nomike/doxy-replacement-shell/print-instructions.md

See <doxy-replacement-shell-v2.scad> for details on how to print and assemble this.
