nomike/doxy-replacement-shell/(commit log)

2024-01-22 First commit.
    [doxy-shell.scad]
2024-01-22 Fix connecting ridge and cable cutout.
    [doxy-shell.scad]
2024-01-22 Remove old code.
    [doxy-shell.scad]
2024-01-22 Add connecting ridges to other half.
    [doxy-shell.scad]
2024-01-22 Add comments to code.
    [doxy-shell.scad]
2024-01-22 Add screw holes to screw holders.
    [doxy-shell.scad]
2024-01-22 More details.
    [doxy-shell.scad]
2024-01-22 .stl files are generated. Tell git to ignore them.
2024-01-22 Reduce detail for faster rendering.
    [doxy-shell.scad]
2024-02-08 Fix spelling.
    [doxy-shell.scad]
2024-02-13 Ad GPLv3 header to source file.
    [doxy-shell.scad]
2024-04-05 Adjust grip_cone_with after re-measuring it.
    [doxy-shell.scad]
2024-04-05 Add print-instructions.
2024-04-05 Upload new STL files to thingiverse.
2024-04-07 Fix license header in OpenSCAD file.
    [doxy-shell.scad]
2024-04-08 Fix comment in doxy-shell.scad.
    [doxy-shell.scad]
2024-04-13 Rename openscad file to be more consistent.
    [doxy-replacement-shell.scad]
2024-09-19 Complete rewrite of the script. First draft.
    [doxy-replacement-shell-v2.scad]
2024-09-21 Add function `get_max_dimension`.
    [doxy-replacement-shell-v2.scad]
2024-09-21 Allkow shaft segments to not be hollow.
    [doxy-replacement-shell-v2.scad]
2024-09-21 Multiple improvements and fixes:
    - Support separate `screw_holder_screwhead_insert_offset`s per screw holder.
    - Consider ridge height when calculating `bottom_screw_holder_height`. Otherwise it will be floating ever so slightly in the air and the very thin support structure underneath will fail mid print and caus the print to fail.
    - Clean the other surface. This is needed to get rid of remnants from the screw holder supports.
    - Make screw holder supports configurab le in height by a fraction of the screw holder height.
    - Add button holes and button hole ridges
    [doxy-replacement-shell-v2.scad]
2024-09-22 Make rendering of button- and nonbutton-halfs configurable.
    [doxy-replacement-shell-v2.scad]
2024-09-23 Use correct variable for cable-end screw holder on button half.
    [doxy-replacement-shell-v2.scad]
2024-09-23 Make button half screw holes a bit tighter for a better screw fit.
    [doxy-replacement-shell-v2.scad]
2024-09-23 Cut off a piece from the PCB screw holder to make room for th silicon button-piece.
    [doxy-replacement-shell-v2.scad]
2024-09-23 Increase bottom_screw_holder_x_offset as that screw holder was not connected to the rest of the shaft,
    [doxy-replacement-shell-v2.scad]
2024-09-23 Recess cable screwhead a bitt deeper as the screw didn't bite properly on the other half.
    [doxy-replacement-shell-v2.scad]
2024-09-23 Render both halfs per default.
    [doxy-replacement-shell-v2.scad]
2024-09-23 Fix issue where clean_outer_surface limited screw_holders' height which cause issues when printing due to them not extending towards the build plate.
    [doxy-replacement-shell-v2.scad]
2024-09-23 Calculate aluminium_ring_section_with from new parameters.
    [doxy-replacement-shell-v2.scad]
2024-09-23 Get shaft_segments variable from new shaft_segments list.
    [doxy-replacement-shell-v2.scad]
2024-09-23 Get grip_cone_bottom_radius variable from new shaft_segments list.
    [doxy-replacement-shell-v2.scad]
2024-09-23 Remove unused variable.
    [doxy-replacement-shell-v2.scad]
2024-09-23 Mark two old variables as a todo to calculate them from the shaft segments.
    [doxy-replacement-shell-v2.scad]
2024-09-23 Fix accidentally changed clean_outer_surfaces to false in recent commit.
    [doxy-replacement-shell-v2.scad]
2024-09-24 Remove a screw-holder support which was blocking the motor.
    [doxy-replacement-shell-v2.scad]
2024-09-24 Make front section a bit narrower as the aluminium ring did not fit on it.
    [doxy-replacement-shell-v2.scad]
2024-09-26 Make button-holes slightly bigger for buttons not to get stuck.
    [doxy-replacement-shell-v2.scad]
2024-09-26 Make screw holes narrower for screws to be seated more firmly.
    [doxy-replacement-shell-v2.scad]
2024-09-26 Complete rewrite code for generating screw-thingies. Remove old unused screw-holder code. Fix some z-fighting issues. Fix screw-thingy lengths. Add recess for hex-nut in button-half as the screw didn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
    [doxy-replacement-shell-v2.scad]
2024-09-26 Cleanup some commented old code.
    [doxy-replacement-shell-v2.scad]
2024-10-11 Fix screw-holder offsets.
    Add TODO comments for hardcoded values.
    [doxy-replacement-shell-v2.scad]
2024-10-11 Add TODO comments for hardcoded values.
    [doxy-replacement-shell-v2.scad]
2024-10-12 Add documentation. Prefix internal recursion variables with an underscore.
    [doxy-replacement-shell-v2.scad]
2024-10-12 Turn on outer surface cleaning per default.
    [doxy-replacement-shell-v2.scad]
2024-10-12 Remove debug echo statements.
    [doxy-replacement-shell-v2.scad]
2024-10-12 Remove legacy design as it was replaced by v2 which was re-written from scratch.
    [doxy-replacement-shell.scad]
2024-10-12 Update print-instructions.
